Foot-Mouse-for-Sally/Foot-Mouse-For-Sally/(commit log)

2025-01-15 added arduino file
2025-03-01 Switched to polling
